wagiminator/ATmega-EEPROM-Programmer/documentation/EEPROM_pic5.jpg

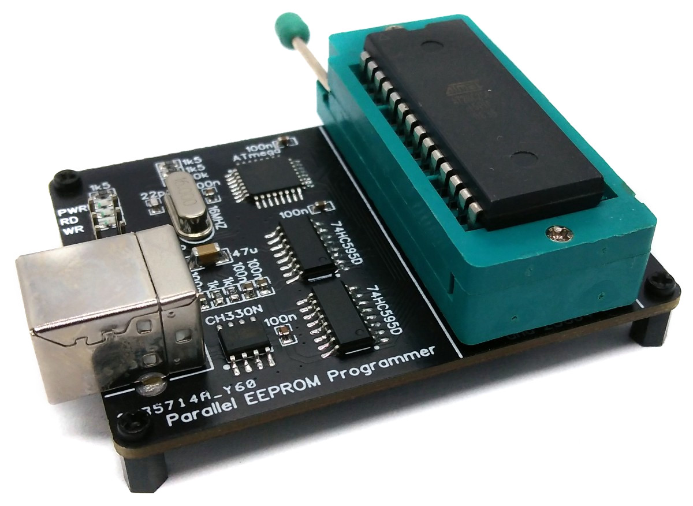
documentation/EEPROM_pic5.jpg
