wagiminator/ATmega-EEPROM-Programmer/documentation/EEPROM_pic6.jpg

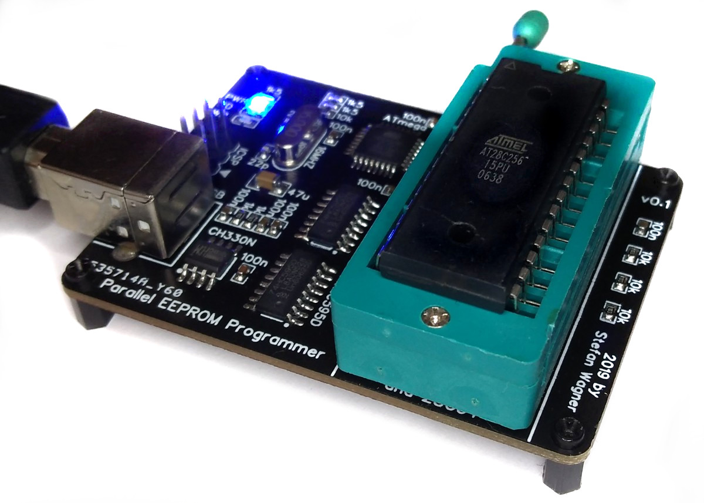
documentation/EEPROM_pic6.jpg
