wagiminator/ATmega-EEPROM-Programmer/documentation/EEPROM_pic7.jpg

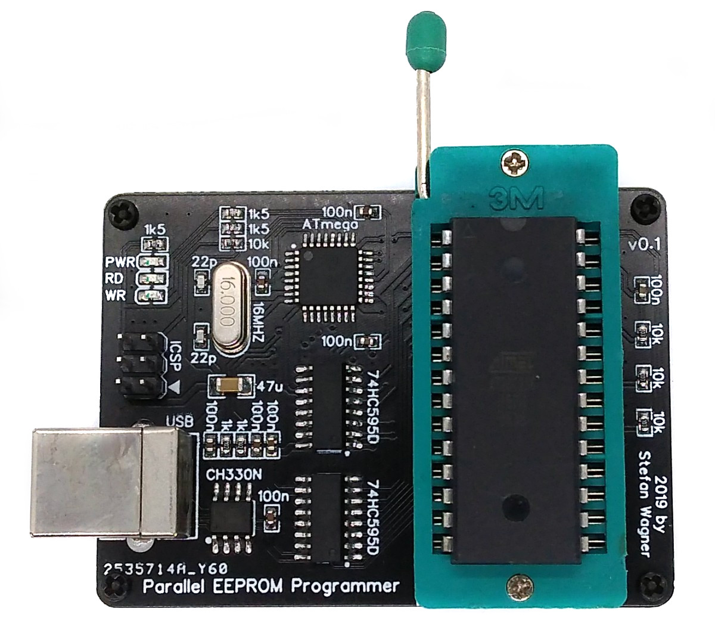
documentation/EEPROM_pic7.jpg
