wagiminator/ATmega-EEPROM-Programmer/hardware/EEPROM_programmer_BOM_v1.0.tsv

ID | Name | Designator | Footprint | Quantity | Manufacturer Part | Manufacturer | Supplier | Supplier Part | LCSC Assembly
1 | CH330N | U2 | SOP-8_150MIL | 1 | CH330N | WCH | LCSC | C108996
2 | 16MHZ | X1 | HC-49S | 1 | X49SD16MSD2SI | Yangxing Tech | LCSC | C188201
3 | USB-B-Female | USB1 | USB-M-49 | 1 | USB-B-Female-90-TH |  | LCSC | C46393
4 | 74HC595D | U4,U3 | SOP-16_150MIL | 2 | SM74HC595D | MINGWEI | LCSC | C93838 | Yes
5 | 1k | R3,R2,R4,R5,R6 | 0603 | 5 | 0603WAF1001T5E | UniOhm | LCSC | C21190
6 | 10k | R1,R7,R9,R8 | 0603 | 4 | 0603WAF1002T5E | UniOhm | LCSC | C25804
7 | ICSP-6 | ICSP1 | ICSP-6 | 1 | ?
8 | 22p | C6,C5 | 0603 | 2 | CL10C220JB8NNNC | SAMSUNG | LCSC | C1653
9 | 100n | C8,C11,C3,C2,C10,C1,C7,C9 | 0603 | 8 | CC0603KRX7R9BB104 | YAGEO | LCSC | C14663
10 | 47u | C4 | 1206 | 1 | 1206F476M160NT | FH | LCSC | C30300
11 | WRITE | LED3 | LED-0603 | 1 | KT-0603R | KENTO | LCSC | C2286
12 | READ | LED2 | LED-0603 | 1 | KT-0603R | KENTO | LCSC | C2286
13 | PWR | LED1 | LED-0603 | 1 | 19-217/BHC-ZL1M2RY/3T | EVERLIGHT | LCSC | C72041
14 | 28C256 | U5 | DIP28 WIDE PACKAGE BIGHOLE | 1
15 | ATMEGA8/168/328 | U1 | TQFP-32_7X7X08P | 1 | ATMEGA328P-AU | MICROCHIP | LCSC | C14877 | Yes
