wagiminator/ATmega-EEPROM-Programmer/hardware/EEPROM_programmer_schematic_v1.0.pdf

## Microcontroller

Address Bus Shifter | ICSP Header

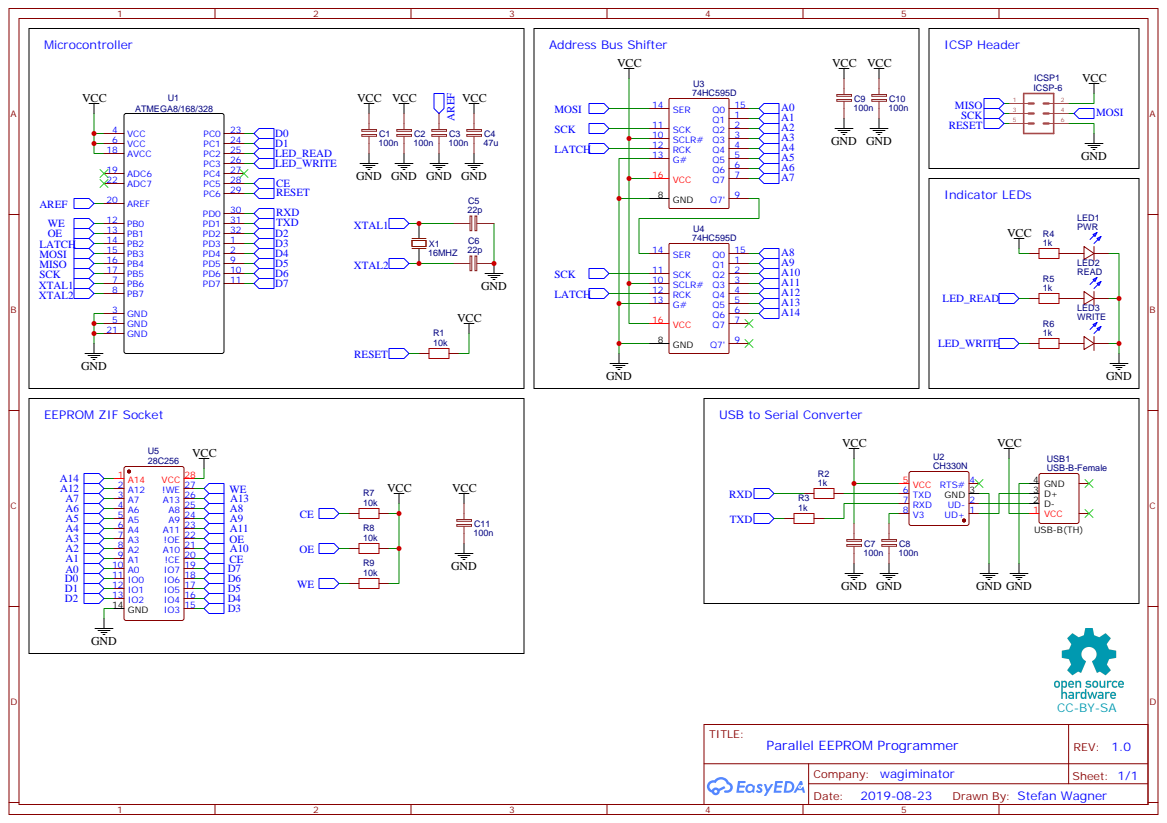
[picture p9: page 1]

GND GND

USB to Serial Converter

Drawn By: Stefan Wagner
