wagiminator/ATmega-EEPROM-Programmer/(threads)

Thread 2 (2022-06-02):

Programmer not found

VectorFever, 2022-06-02:
Hi! I made this programmer with Arduino Nano. I have checked all connections, everything is ok. Anyways "EEPROM Programmer not found" error pops up from ui application and finddevice.py too. While in Arduino IDE memory dump works fine(A lot of garbage when there is no ic in socket and all zeros when it is). But when I'm trying to run memory fill command Arduino just freezes and doesn't respond until I reset it. There is Python 3.9 with pyserial-3.5 and tkinter on my PC, Windows 10. I will be glad if You help!

wagiminator, 2022-11-24:
Did you use a CH330N or CH340N as a USB to serial converter? If you connected the Nano via its USB port, it probably wasn't recognized due to an incorrect identifier (VID/PID). But then you can change it in the Python script.

Thread 3 (2023-04-27):

Porting to raspberry pi pico

brtgio, 2023-04-27:
Hey, how dificulte would it be to port the programmer to raspberry pi pico?

wagiminator, 2023-05-01:
I haven't worked with the pico yet. I don't know if it can handle 5V. If not, you still need level shifters. Porting the code shouldn't be a problem (if you are familiar with the pico;-).

brtgio, 2023-05-01:
I'm new to the 6502 world and eeprom programming  ,I'm gonna try porting
it my self,thanks for the help.

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

Thread 4 (2023-10-27):

I make a 29 programmer base on your board,but can not run on 1Mbps，only 115200

happysoul, 2023-10-27:
I used auto routing software by "freerouting"

PCB
https://oshwhub.com/firseve/eeprom_29
Source code
https://gitee.com/happysoul/eeprom29

If i use 1000000 , read/write may lost byte.  When read chip of  MX29F040 512KB, but recived about 500K .
So i change baudrate to 115200, it looks well, somebody make this board and replace chip , routing , but only can run with 115200/2=57600

How to make a high speed programmer.  Problem becouse of autorouting ?

wagiminator, 2023-10-28:
Hi, unfortunately I can't tell you from a distance why it doesn't work with 1MHz UART BAUD. However, I can reassure you that this shouldn't be a problem when writing the EEPROM, UART is not the bottleneck here. You just don't reach full speed when reading.

happysoul, 2023-10-30:
O.O  Maybe use arduino language is the resion that can not reach full speed.
Like read 8bit,  8 times read each bit " digitalRead(Data0-8) ", then put 8bit into byte , return byte
Your code use PINC&PIND recive byte

wagiminator, 2023-10-31:
Well, at least my code is very low-level optimized.
